AYUSH-pro-grammer/usb_hub/cad/printables_usb_hub_part-2.stl

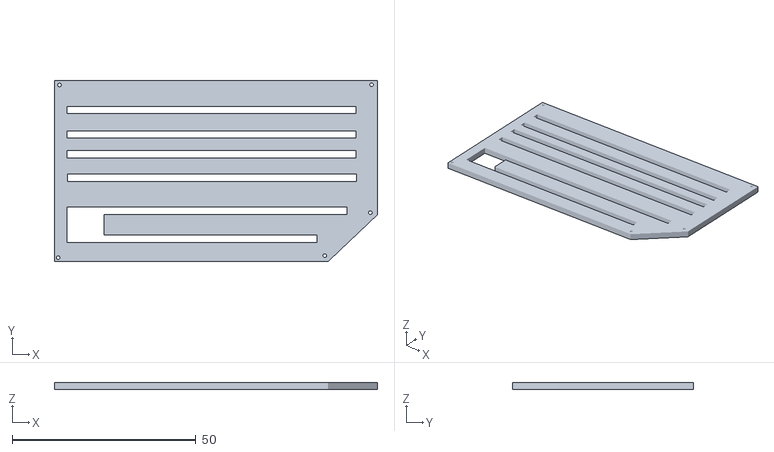
[picture p8: CAD file, 2026-11-04]
cad/printables_usb_hub_part-2.stl
87.9 x 49.2 x 2.00
