AYUSH-pro-grammer/usb_hub/cad/printables-usb-hub-p1.stl

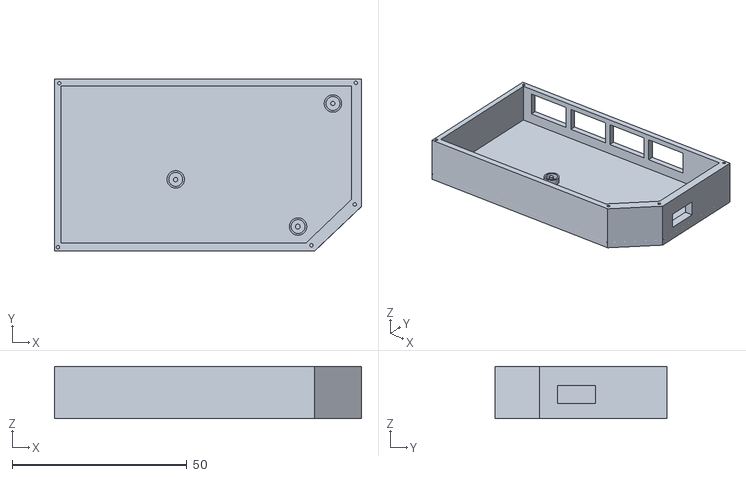
[picture p9: CAD file, 2026-11-04]
cad/printables-usb-hub-p1.stl
87.9 x 49.3 x 15.0
