AYUSH-pro-grammer/usb_hub/cad/USB_HUB_PCB.step

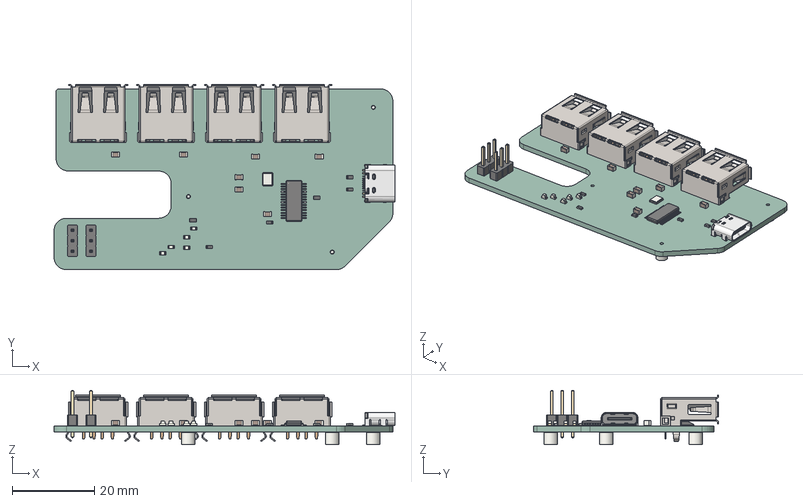
[picture p10: CAD file, 2026-11-01]
cad/USB_HUB_PCB.step
83.0 x 45.1 x 13.2 mm
R_0603_1608Metric x 6
USB Connector Type A female x 5
C_0805_2012Metric x 7
ConPins
PcbPins
Mold
Frame
LED_0603_1608Metric x 5
PinHeader_1x03_P254mm_Vertical x 2
Crystal_SMD_3225-4Pin_3.2x2.5mm
SSOP-28_3.9x9.9mm_P0.635mm
Mounting_Wuerth_WA-SMSI-M1.6_H3mm_ThreadDepth1.8mm_97730306332 x 3
Untitled-unsaved-export-QRNoQY_PCB
