AYUSH-pro-grammer/usb_hub/(list of files, cad)

Other CAD files:
cad/usb_hub.f3z
