AYUSH-pro-grammer/usb_hub/kicad/usb_hub.kicad_pcb

## KiCad design kicad/usb_hub.kicad_pcb (2026-11-01)

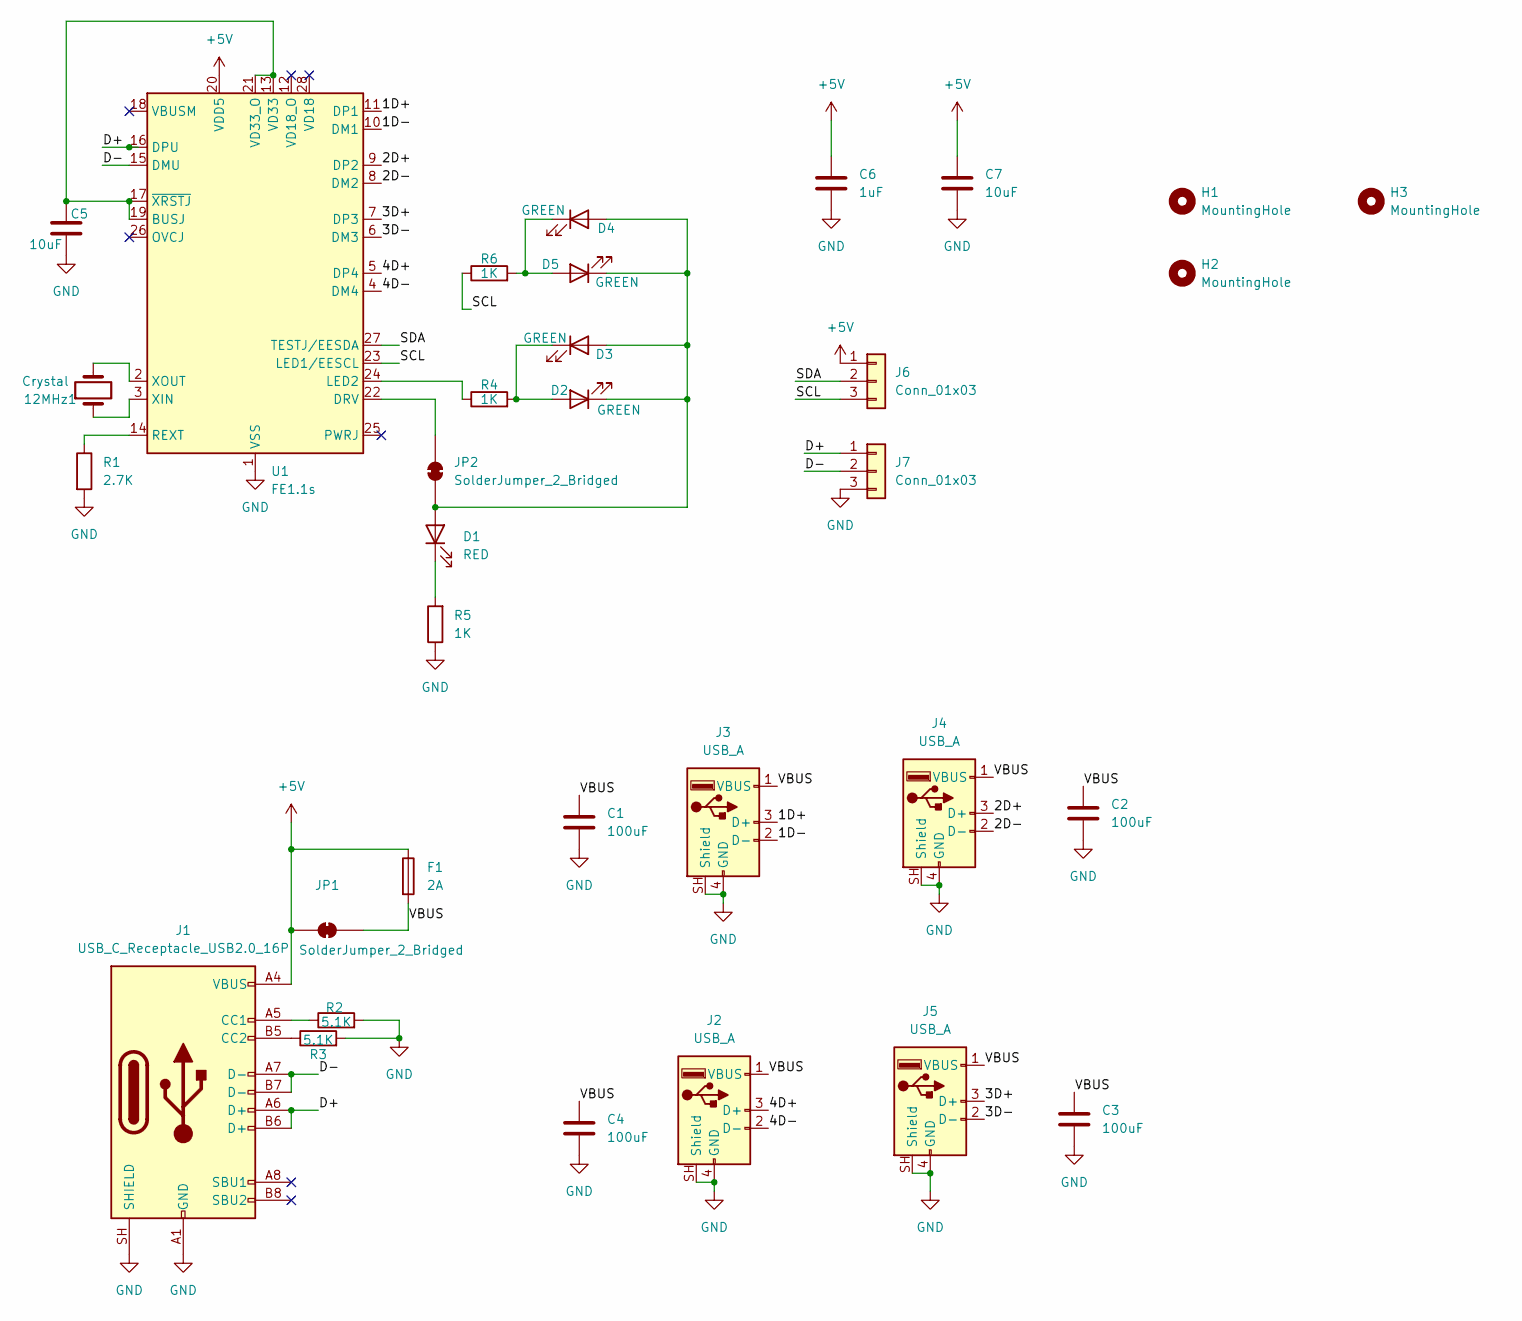
[picture p11: schematic usb_hub.kicad_sch]

Parts:
12MHz1: Crystal; Crystal_SMD_3225-4Pin_3.2x2.5mm
C1, C2, C3, C4: 100uF; C_0805_2012Metric
C5, C7: 10uF; C_0805_2012Metric
C6: 1uF; C_0805_2012Metric
D1: RED; LED_0603_1608Metric
D2, D3, D4, D5: GREEN; LED_0603_1608Metric
F1: 2A; Fuse_1812_4532Metric
H1, H2, H3: MountingHole; Mounting_Wuerth_WA-SMSI-M1.6_H3mm_ThreadDepth1.8mm_97730306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
J1: USB_C_Receptacle_USB2.0_16P; USB_C_Receptacle_HRO_TYPE-C-31-M-12
J2, J3, J4, J5: USB_A; USB_A_Receptacle_GCT_USB1046
J6, J7: Conn_01x03; PinHeader_1x03_P2.54mm_Vertical
JP1, JP2: SolderJumper_2_Bridged; SolderJumper-2_P1.3mm_Open_RoundedPad1.0x1.5mm
R1: 2.7K; R_0603_1608Metric
R2, R3: 5.1K; R_0603_1608Metric
R4, R5, R6: 1K; R_0603_1608Metric
U1: FE1.1s; SSOP-28_3.9x9.9mm_P0.635mm

Connections:
+5V: C6.1, C7.1, F1.1, J1.A4 (VBUS), J1.A9 (VBUS), J1.B4 (VBUS), J1.B9 (VBUS), J6.1, JP1.1 (A), U1.20 (VDD5)
/1D+: J3.3 (D+), U1.11 (DP1)
/1D-: J3.2 (D-), U1.10 (DM1)
/2D+: J4.3 (D+), U1.9 (DP2)
/2D-: J4.2 (D-), U1.8 (DM2)
/3D+: J5.3 (D+), U1.7 (DP3)
/3D-: J5.2 (D-), U1.6 (DM3)
/4D+: J2.3 (D+), U1.5 (DP4)
/4D-: J2.2 (D-), U1.4 (DM4)
/D+: J1.A6 (D+), J1.B6 (D+), J7.1, U1.16 (DPU)
/D-: J1.A7 (D-), J1.B7 (D-), J7.2, U1.15 (DMU)
/SCL: J6.3, R6.1, U1.23 (LED1/EESCL)
/SDA: J6.2, U1.27 (TESTJ/EESDA)
/VBUS: C1.1, C2.1, C3.1, C4.1, F1.2, J2.1 (VBUS), J3.1 (VBUS), J4.1 (VBUS), J5.1 (VBUS), JP1.2 (B)
GND: C1.2, C2.2, C3.2, C4.2, C5.2, C6.2, C7.2, J1.A1 (GND), J1.A12 (GND), J1.B1 (GND), J1.B12 (GND), J1.SH (SHIELD), J2.4 (GND), J2.SH (Shield), J3.4 (GND), J3.SH (Shield), J4.4 (GND), J4.SH (Shield), J5.4 (GND), J5.SH (Shield), J7.3, R1.2, R2.2, R3.2, R5.1, U1.1 (VSS)
unnamed: D1.2 (A), D2.1 (K), D3.2 (A), D4.2 (A), D5.1 (K), JP2.1 (A)
unnamed: D1.1 (K), R5.2
unnamed: D2.2 (A), D3.1 (K), R4.2
unnamed: D4.1 (K), D5.2 (A), R6.2
unnamed: J1.A5 (CC1), R2.1
unnamed: J1.B5 (CC2), R3.1
unnamed: JP2.2 (B), U1.22 (DRV)
unnamed: C5.1, U1.13 (VD33), U1.17 (~XRSTJ), U1.19 (BUSJ), U1.21 (VD33_O)
unnamed: R4.1, U1.24 (LED2)
unnamed: R1.1, U1.14 (REXT)
unnamed: 12MHz1.1, U1.3 (XIN)
unnamed: 12MHz1.2, U1.2 (XOUT)

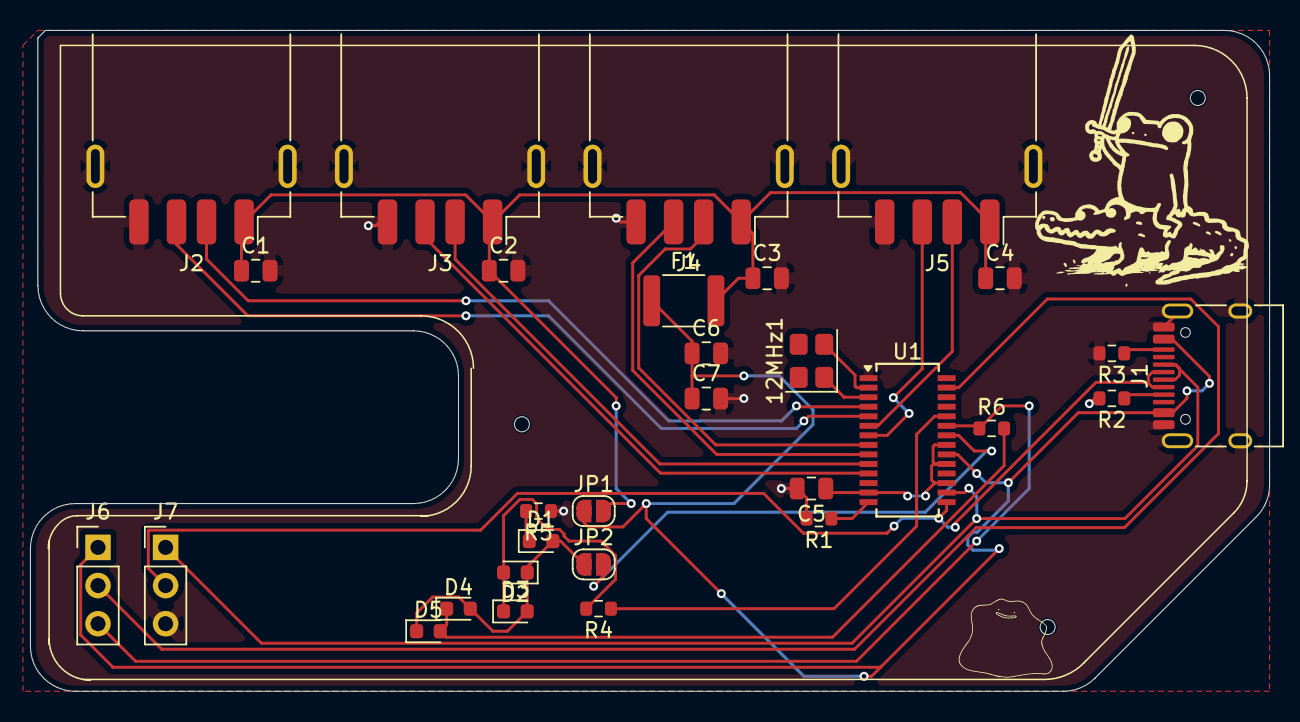
[picture p12: board usb_hub.kicad_pcb from above]

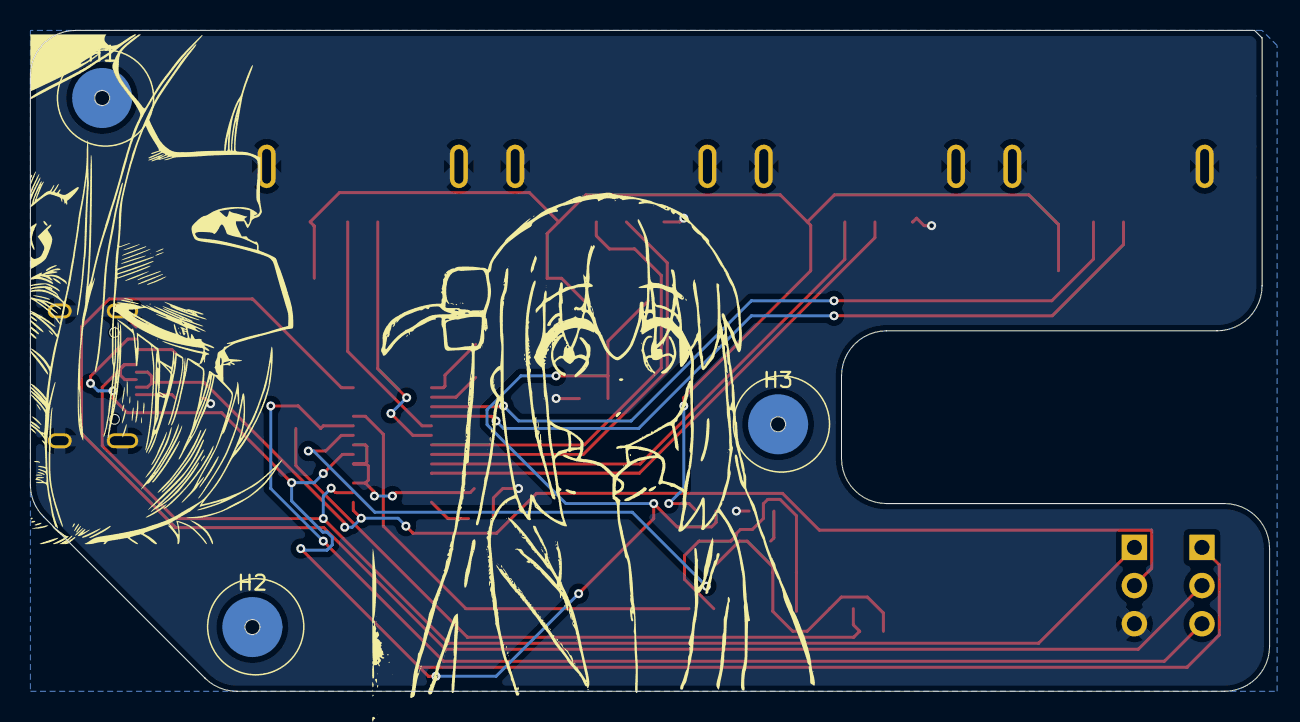
[picture p13: board usb_hub.kicad_pcb from below]

Board: 2 copper layers, 82.5 x 44.0 mm, 33 parts (3 on the bottom side), 27 nets.
