AYUSH-pro-grammer/usb_hub/(commit log)

2026-11-01 added wrong file mb
    [keyboard-print-1.stl, keyboard-print-2.stl]
2026-11-04 Added all
    [bom.csv, printables-usb-hub-p1.stl, printables_usb_hub_part-2.stl]
